Pletea-Marinescu-Valentin/Hold-My-Coffee-Drinks-Stabilization-Platform/docs/Hold_My_Coffee_Presentation.pptx

## Hold My Coffee: Drinks Stabilization Platform

- Valentin Pletea-Marinescu & Sebastian-Alexandru Matei
- Faculty of Automatic Control and Computer Science / Engineering in Foreign Languages
- Active stabilization system preventing beverage spillage during motion.

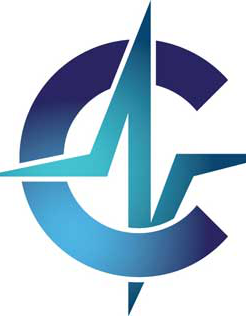
[picture p1: figure]
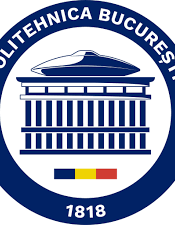
[picture p2: figure]
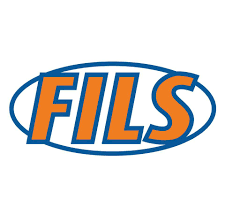
[picture p3: figure]

## Motivation

Spilling drinks while walking or carrying trays is a common issue.
Goal: Keep beverage level even when base moves or tilts.
Applications: Restaurants, hospitals, mobile robots, drones.

## Introduction / Objective

- Design an active mechatronic stabilization platform that maintains level surface.
- 3 Degrees of Freedom: Pitch, Roll, Vertical height.
- Dual-microcontroller architecture for real-time control (Teensy 4.1 & Arduino UNO).

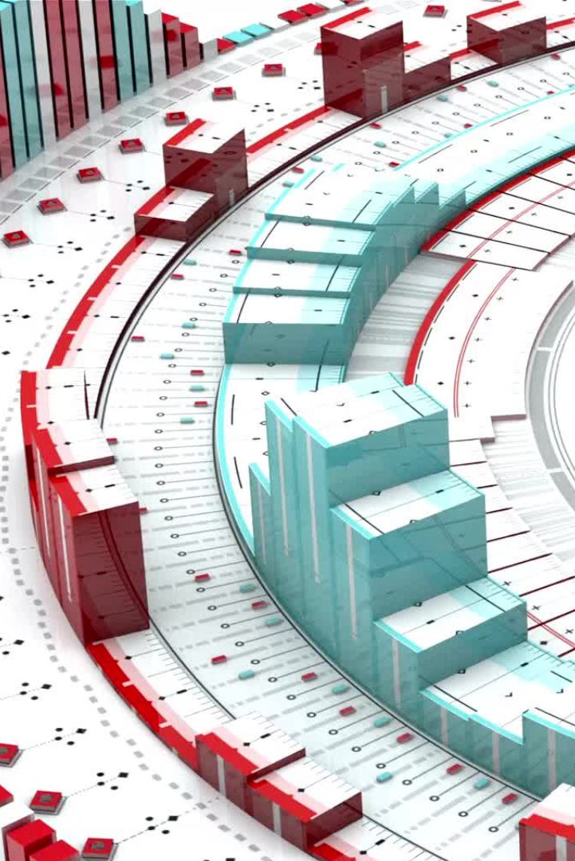
[picture p4: figure]

## Current State of the Field

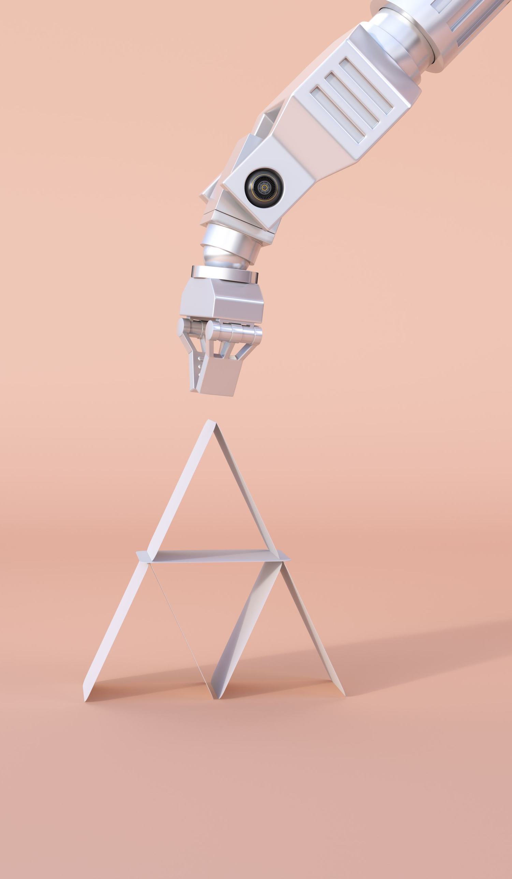
[picture p5: figure]
Claw building a card house

- Camera gimbals: high-precision stabilization (DJI, Zhiyun).
- Tank & ship systems: large loads, slower response.
- Robot stabilization: self-balancing & predictive control.
- Gap: No small, affordable beverage stabilizer exists.

## Features / Innovations

Dual-microcontroller real-time architecture.
Cascaded PID control for pitch, roll, and height.
Vertical stabilization (unique among gimbals).
Modular 3D-printed design for easy maintenance.

## Hardware Overview

- Main controller: Teensy 4.1 (600 MHz ARM Cortex-M7).
- Secondary controller: Arduino UNO for height & servo control.
- Actuators: 3x mj5208 brushless motors + Moteus r4.11 controllers.
- Sensors: BNO055 IMU & VL53L8CX Time-of-Flight sensor.
- Power: LiPo 14.8V, 300A switch & fuse protection.

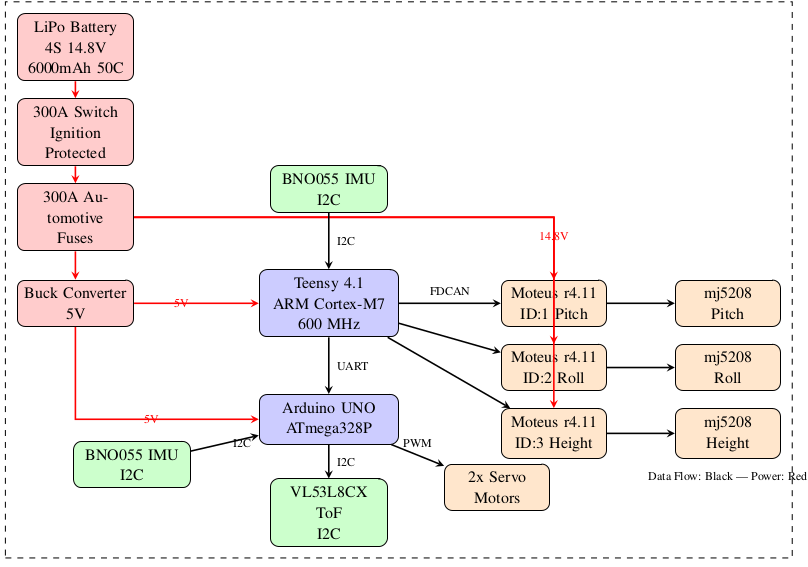
[picture p6: figure]

## Mechanical Design

- 3D printed ABS/PETG parts + aluminum extrusions.
- Vertical motion via ACME T8 lead screw + MGN linear rails.
- Modular, replaceable structure for flexibility and repairability.

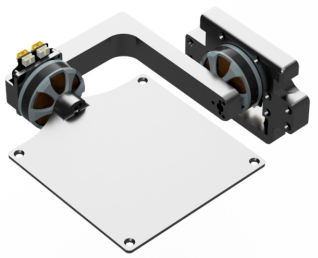
[picture p7: figure]
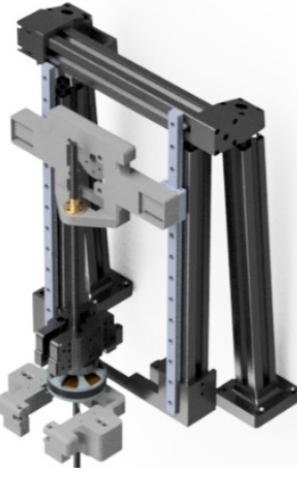
[picture p8: figure]

## Control & Software

- Cascaded PID loops: Teensy high-level control, Moteus low-level loops.
- 20 Hz control rate, low-latency FDCAN communication.
- Quaternion to Euler conversion for orientation control.
- Sensor fusion via complementary filter.

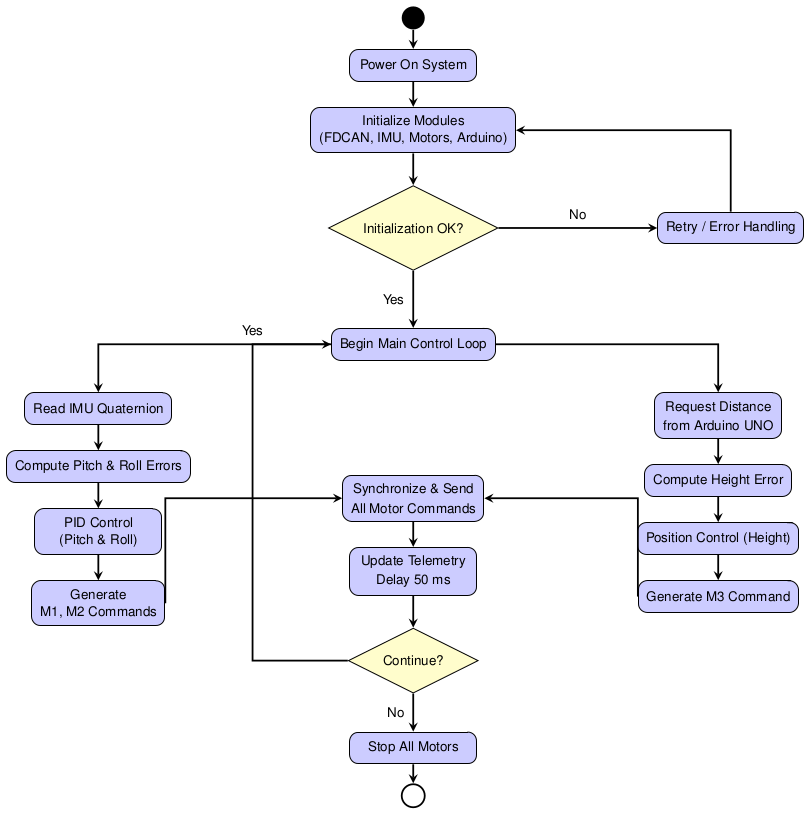
[picture p9: figure]

## Performance & Demonstration

- Stable within ±1° tilt, recovery < 0.2 seconds.
- No spillage for base tilt up to 90°.
- Battery runtime: 3 hours continuous operation.
- Smooth and fast control response observed.

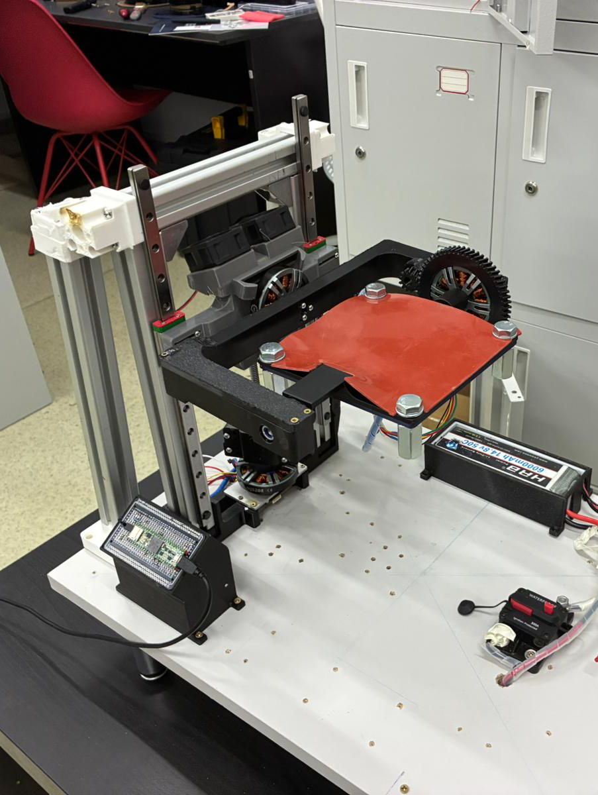
[picture p10: figure]

## Challenges & Improvements

- PID tuning for changing center of mass (varying liquid levels).
- Mechanical alignment and backlash issues.
- Future: adaptive or ADRC control, faster sensors, wireless monitoring.

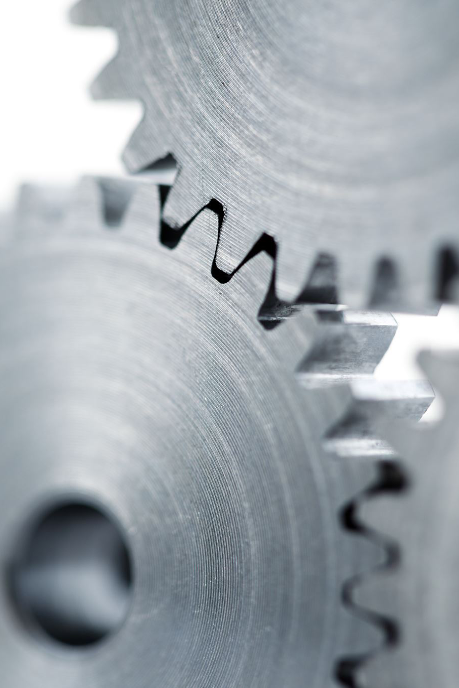
[picture p11: figure]
Gears

## Conclusions

Fully functional multi-axis active stabilization platform.
Demonstrates real-time mechatronic control and integration.
Achieves low-cost alternative to professional stabilizers.

## Summary of Contributions

Valentin: Software design (PID control, sensor fusion, communication).
Sebastian: Hardware & mechanical system design, integration.
Joint: Testing, safety systems, documentation, final demonstration.
Main takeaway: Engineering precision applied to daily-life stability.
