Pletea-Marinescu-Valentin/Hold-My-Coffee-Drinks-Stabilization-Platform/(commit log)

2025-10-31 feat: add Teensy 4.1 and Arduino UNO stabilization firmware
2025-10-31 Add HoldMyCoffee_UNO.ino for sensor integration
    This file contains code for an Arduino UNO project that integrates BNO055 and VL53L0X sensors for orientation and distance measurement, respectively.
